tarantula3/Arduino-Concrete-Clock/Main_Template.pdf

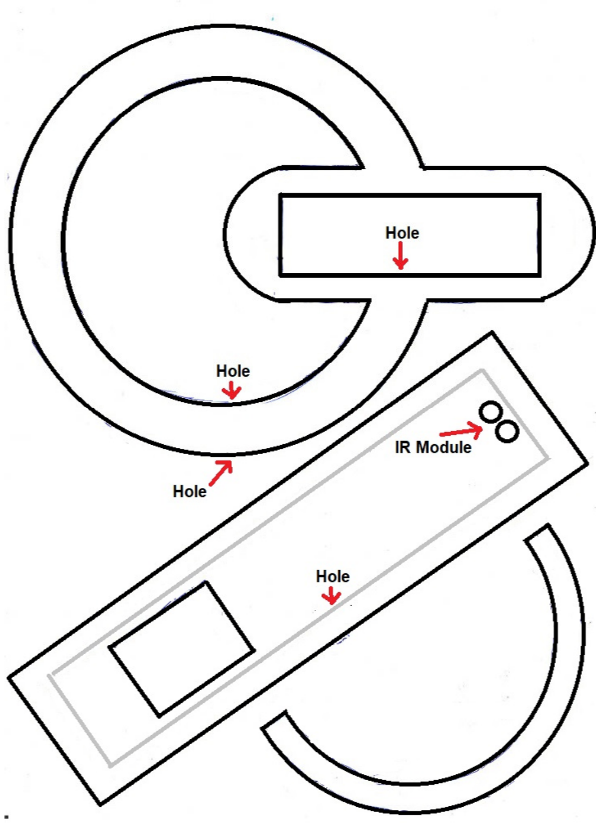
[picture p1: page 1]
